NovaPrime18/GaNymede/GaNymede/Phase_gate.png

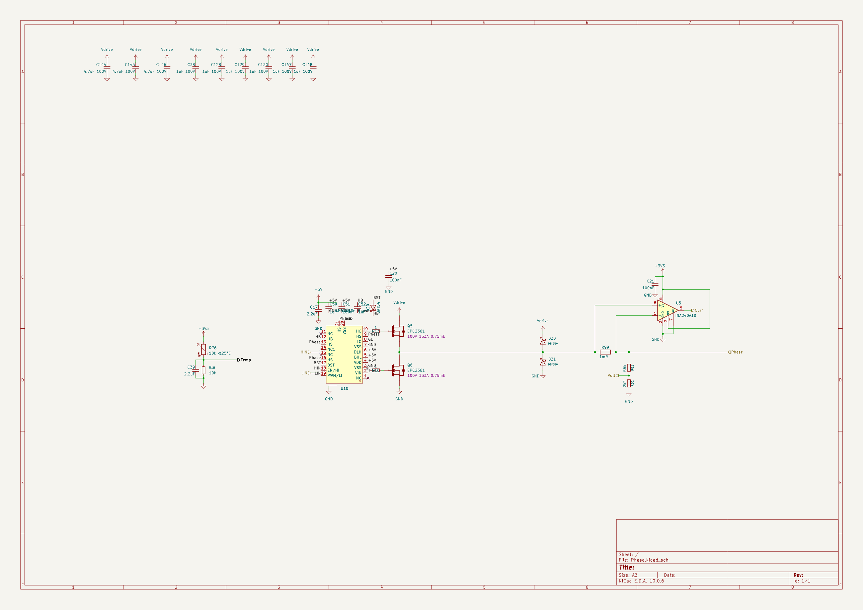
GaNymede/Phase_gate.png
