NovaPrime18/GaNymede/GaNymede/production/bom.csv

Designator | Footprint | Quantity | Value | LCSC Part #
C1, C15, C16, C18, C19, C20, C21, C29, C3, C30, C32, C36, C37, C4, C47, C5, C50, C52, C53, C58, C6, C60, C63, C7, C71, C77 | 0402 | 26 | 100nF | C307331
C10, C13, C14, C17, C27, C28, C39, C9 | 0402 | 8 | 2.2uF | C20539421
C11, C12 | 0402 | 2 | 15pF | C1548
C110, C111, C112, C113, C115, C116, C117, C118 | CP_Elec_10x10 | 8 | 100uF 80V | C487410
C119 | 0402 | 1 | 100n
C122, C123, C124, C125, C126, C127, C128, C129, C130, C136, C137, C138, C139, C147, C148, C33, C35, C38 | 0805 | 18 | 1uF 100V | C5370002
C134, C135, C140, C141, C142, C143, C144, C145, C146 | 1206 | 9 | 4.7uF 100V | C22367839
C150, C151, C152, C153, C154, C155, C156, C157, C158, C159, C160, C161 | CP_Elec_8x10 | 12 | 47uF 100V | C48935391
C2, C34, C8 | 0805 | 3 | 10uF | C440198
C201, C202, C203 | 0805 | 3 | 2.2nF 100V | C107136
C31 | 0402 | 1 | 1uF | C52923
C48, C57, C66 | 0402 | 3 | 15nF | C114405
C49, C59, C68 | 0402 | 3 | 1nF | C1523
C51, C64, C70, C74, C75, C76 | 0402 | 6 | 1uF
C54, C67, C73 | 0402 | 3 | 100nF
C55, C90 | 0603 | 2 | 100n X7R 100V | C15725
C56, C61, C62, C86, C87, C88 | 0805 | 6 | 1u X7R 100V | C5370002
C65, C69, C72, C91, C92, C93 | 0805 | 6 | 10u X7R 25V | C3039694
D1 | 0603 | 1 | Red | C2286
D14, D23 | D_SOD-123F | 2 | MBR1H100SFT3G | C235757
D2 | 0603 | 1 | Green | C84267
D22, D24, D25 | 0603 | 3 | LED | C2286
D27 | D_SMA | 1 | SMAJ60A | C42394398
D4 | D_SOD-123 | 1 | BAV16W | C459527
D6, D7, D8 | D_SOD-323 | 3 | BAT46WS | C7502692
F2 | 0805 | 1 | 0.5A | C2833485
FB2 | 0402 | 1 | 600R@100MHz | C76884
J1 | TH_XT90PB-M | 1 | XT90 | C3040688
J4 | JST_PH_B6B-PH-SM4-TB_1x06-1MP_P2.00mm_Vertical | 1 | Hall | C471518
J5 | JST_PH_B8B-PH-SM4-TB_1x08-1MP_P2.00mm_Vertical | 1 | COMM | C495548
J7 | TYPE-C-SMD_HX-TYPE-C-16PIN | 1 | Connector, USB-TYPE-C-16P | C2927039
L2, L3 | L_Sunlord_SWPA4030S | 2 | 22uH 1A 0.29Ohm | C167883
Q1, Q2, Q3, Q4, Q5, Q6 | D0606F_100V | 6 | EPC2361
R1, R42, R43 | 0402 | 3 | 22 | C25092
R10 | 0402 | 1 | 4.7 | C25121
R100, R101, R102, R97, R98, R99 | 2512 | 6 | 0.5mR
R105, R106 | 0402 | 2 | 5.1k | C25905
R11, R12, R14, R18, R48, R49, R50 | 0402 | 7 | 10k | C25744
R13, R15, R16, R17, R19, R20 | 0402 | 6 | 2.2
R2, R3, R67, R72, R78 | 0402 | 5 | 1k | C11702
R201, R202, R203 | 1210 | 3 | 1 | C2974068
R39, R46, R51, R58 | 0603 | 4 | 56k | C23206
R4, R5, R6 | 0402 | 3 | 2k2
R40, R47, R52, R59 | 0402 | 4 | 2k2 | C25879
R41 | 0603 | 1 | 220 | C22962
R7 | 0402 | 1 | 10k
R74, R75, R76 | 0402 | 3 | 10k @25°C | C77131
R77, R95 | 0402 | 2 | 1k | C106235
R79 | 0402 | 1 | 50k | C25897
R86 | 0402 | 1 | 33k 1% | C138003
R92 | 0402 | 1 | 10k 0.1% | C190095
R93 | 0402 | 1 | 57.6k 0.1% | C852849
R94 | 0402 | 1 | 10k | C2906861
SW1, SW2 | SW_Push_1P1T_NO_CK_KMR2 | 2 | KMR211NGLFS | C221676
TP1 | TestPoint_Pad_D1.5mm | 1 | Enable
TP2 | TestPoint_Pad_D1.5mm | 1 | TestPoint
TP3 | TestPoint_Pad_D1.5mm | 1 | Red
TP4 | TestPoint_Pad_D1.5mm | 1 | Green
U1 | LQFP-64_10x10mm_P0.5mm | 1 | STM32F405RGTx | C15742
U10, U11, U12, U13, U14, U17 | SOT-353_SC-70-5 | 6 | 74LVC1G66 | C97489
U15, U16 | SOT-23-6 | 2 | LMR16006XDDCR | C87080
U18, U7 | HVSON-8-1EP_3x3mm_P0.65mm_EP1.6x2.4mm | 2 | TJA1051TK-3 | C2875699
U19, U20, U21 | WQFN-19_L4.0-W3.0-P0.50-BL-EP_LMG1210RVRR | 3 | LMG1210 | C2677136
U3, U4, U5 | SOIC-8_3.9x4.9mm_P1.27mm | 3 | INA240A1D | C1346458
U8 | ESP32-C3-WROOM-02 | 1 | ESP32-C3-WROOM-02 | C2934560
Y1 | Crystal_SMD_3225-4Pin_3.2x2.5mm | 1 | 8M | C2682775
