NovaPrime18/GaNymede/GaNymede/GaNymede-Housing.FCStd

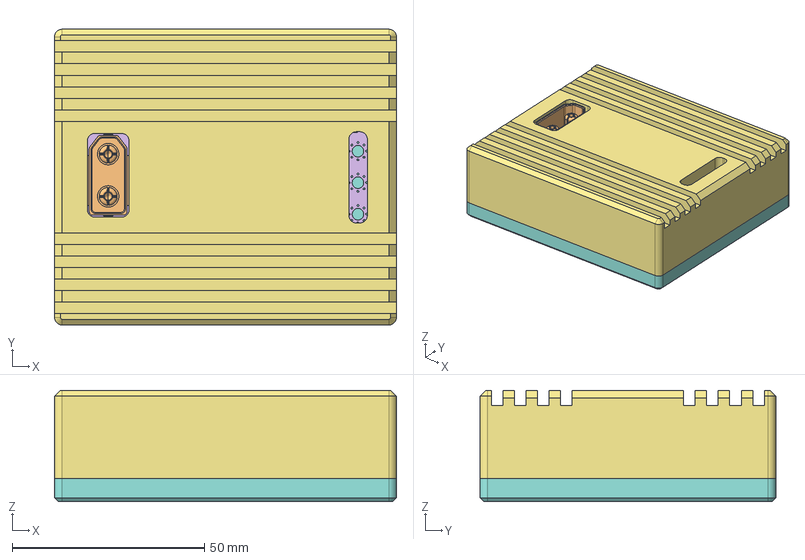
[picture p4: CAD file, 2026-11-08]
GaNymede/GaNymede-Housing.FCStd
89.0 x 77.0 x 29.0 mm
C_0805_2012Metric
R_0402_1005Metric
C_0805_2012Metric002
C_0805_2012Metric004
D_SOD_323
R_2512_6332Metric
C_0402_1005Metric
CP_Elec_10x10
C_0805_2012Metric006
R_2512_6332Metric002
R_0402_1005Metric002
C_0402_1005Metric002
R_1210_3225Metric
C_1206_3216Metric
R_0402_1005Metric004
Green001
Green002
Green003
Green004
Green005
Green006
Green007
Extruded
Extruded001
Extruded002
Extruded003
Extruded004
Extruded005
Extruded006
Extruded007
Extruded008
C_0805_2012Metric008
C_0805_2012Metric010
C_0402_1005Metric004
C_0402_1005Metric006
C_0805_2012Metric012
D_SOD_324
CP_Elec_10x002
R_1210_3225Metric002
C_0805_2012Metric014
CP_Elec_8x10
R_0402_1005Metric006
Green009
Green010
Green011
Green012
Green013
Green014
Green015
Extruded009
Extruded010
Extruded011
Extruded012
Extruded013
Extruded014
Extruded015
Extruded016
Extruded017
C_0402_1005Metric008
CP_Elec_8x002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
