NovaPrime18/GaNymede/GaNymede/GaNymede.step

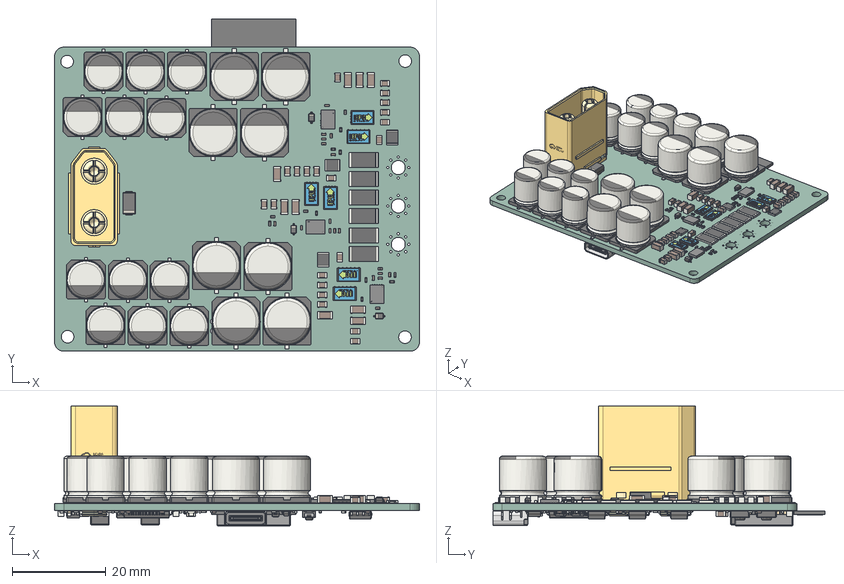
[picture p5: CAD file, 2026-11-08]
GaNymede/GaNymede.step
78.0 x 71.0 x 25.6 mm
C_0805_2012Metric x 36
R_0402_1005Metric x 42
D_SOD_323 x 3
R_2512_6332Metric x 6
C_0402_1005Metric x 53
CP_Elec_10x10 x 8
R_1210_3225Metric x 3
C_1206_3216Metric x 9
Green001 x 6
Green002 x 6
Green003 x 6
Green004 x 6
Green005 x 6
Green006 x 6
Green007 x 6
Extruded x 6
Extruded001 x 6
Extruded002 x 6
Extruded003 x 6
Extruded004 x 24
Extruded008 x 6
CP_Elec_8x10 x 12
WQFN-19_L4.0-W3.0-P0.50-BL-EP_LMG1210RVRR x 3
D_SMA
TH_XT90PB-M
SOT-353_SC-70-5 x 6
SOT-23-6 x 2
R_0603_1608Metric x 5
D_SOD_123F x 2
Crystal_SMD_3225-4Pin_3.2x2.5mm
LED_0603_1608Metric x 5
LQFP-64_10x10mm_P0.5mm
C_0603_1608Metric x 2
D_SOD-123
a68460a4-8551-11ed-a139-00155d22e2d7_part x 2
a684622a-8551-11ed-a139-00155d22e2d7_part x 2
a68462b6-8551-11ed-a139-00155d22e2d7_part x 2
R_0805_2012Metric
L_0402_1005Metric
SW_Push_1P1T_NO_CK_KMR2 x 2
SOIC-8_3.9x4.9mm_P1.27mm x 3
ESP32-C3-WROOM-02
TYPE-C-SMD_HX-TYPE-C-16PIN
GaNymede-unsaved-export-G2i9b3_PCB
