NovaPrime18/GaNymede/GaNymede/GaNymede-Housing-Housing-Bottom.step

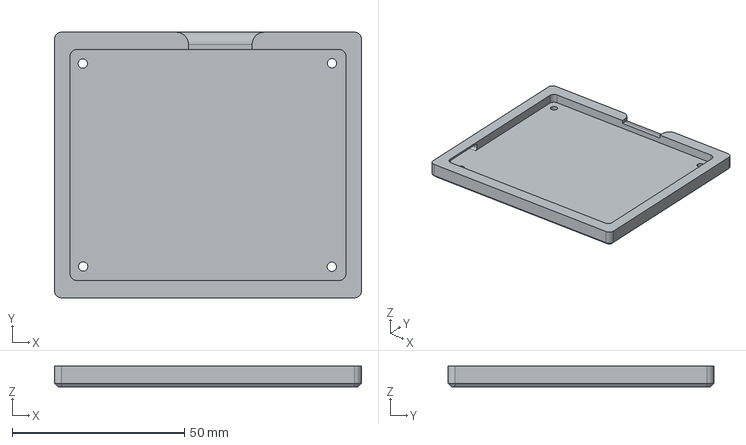
[picture p6: CAD file, 2026-11-08]
GaNymede/GaNymede-Housing-Housing-Bottom.step
89.0 x 77.0 x 6.00 mm
