NovaPrime18/GaNymede/GaNymede/GaNymede-Housing-Housing-Top.step

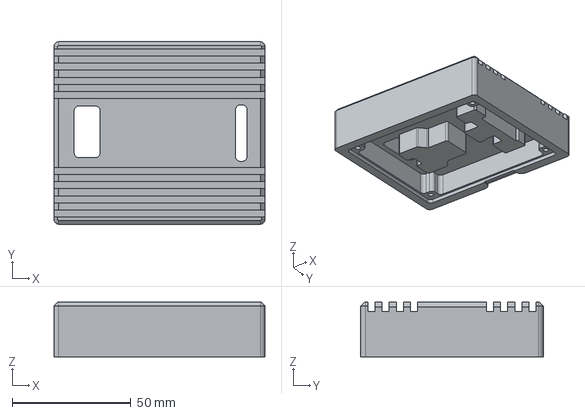
[picture p7: CAD file, 2026-11-08]
GaNymede/GaNymede-Housing-Housing-Top.step
89.0 x 77.0 x 23.0 mm
