NovaPrime18/GaNymede/GaNymede/GaNymede.kicad_pcb

## KiCad design GaNymede/GaNymede.kicad_pcb (2026-11-08)

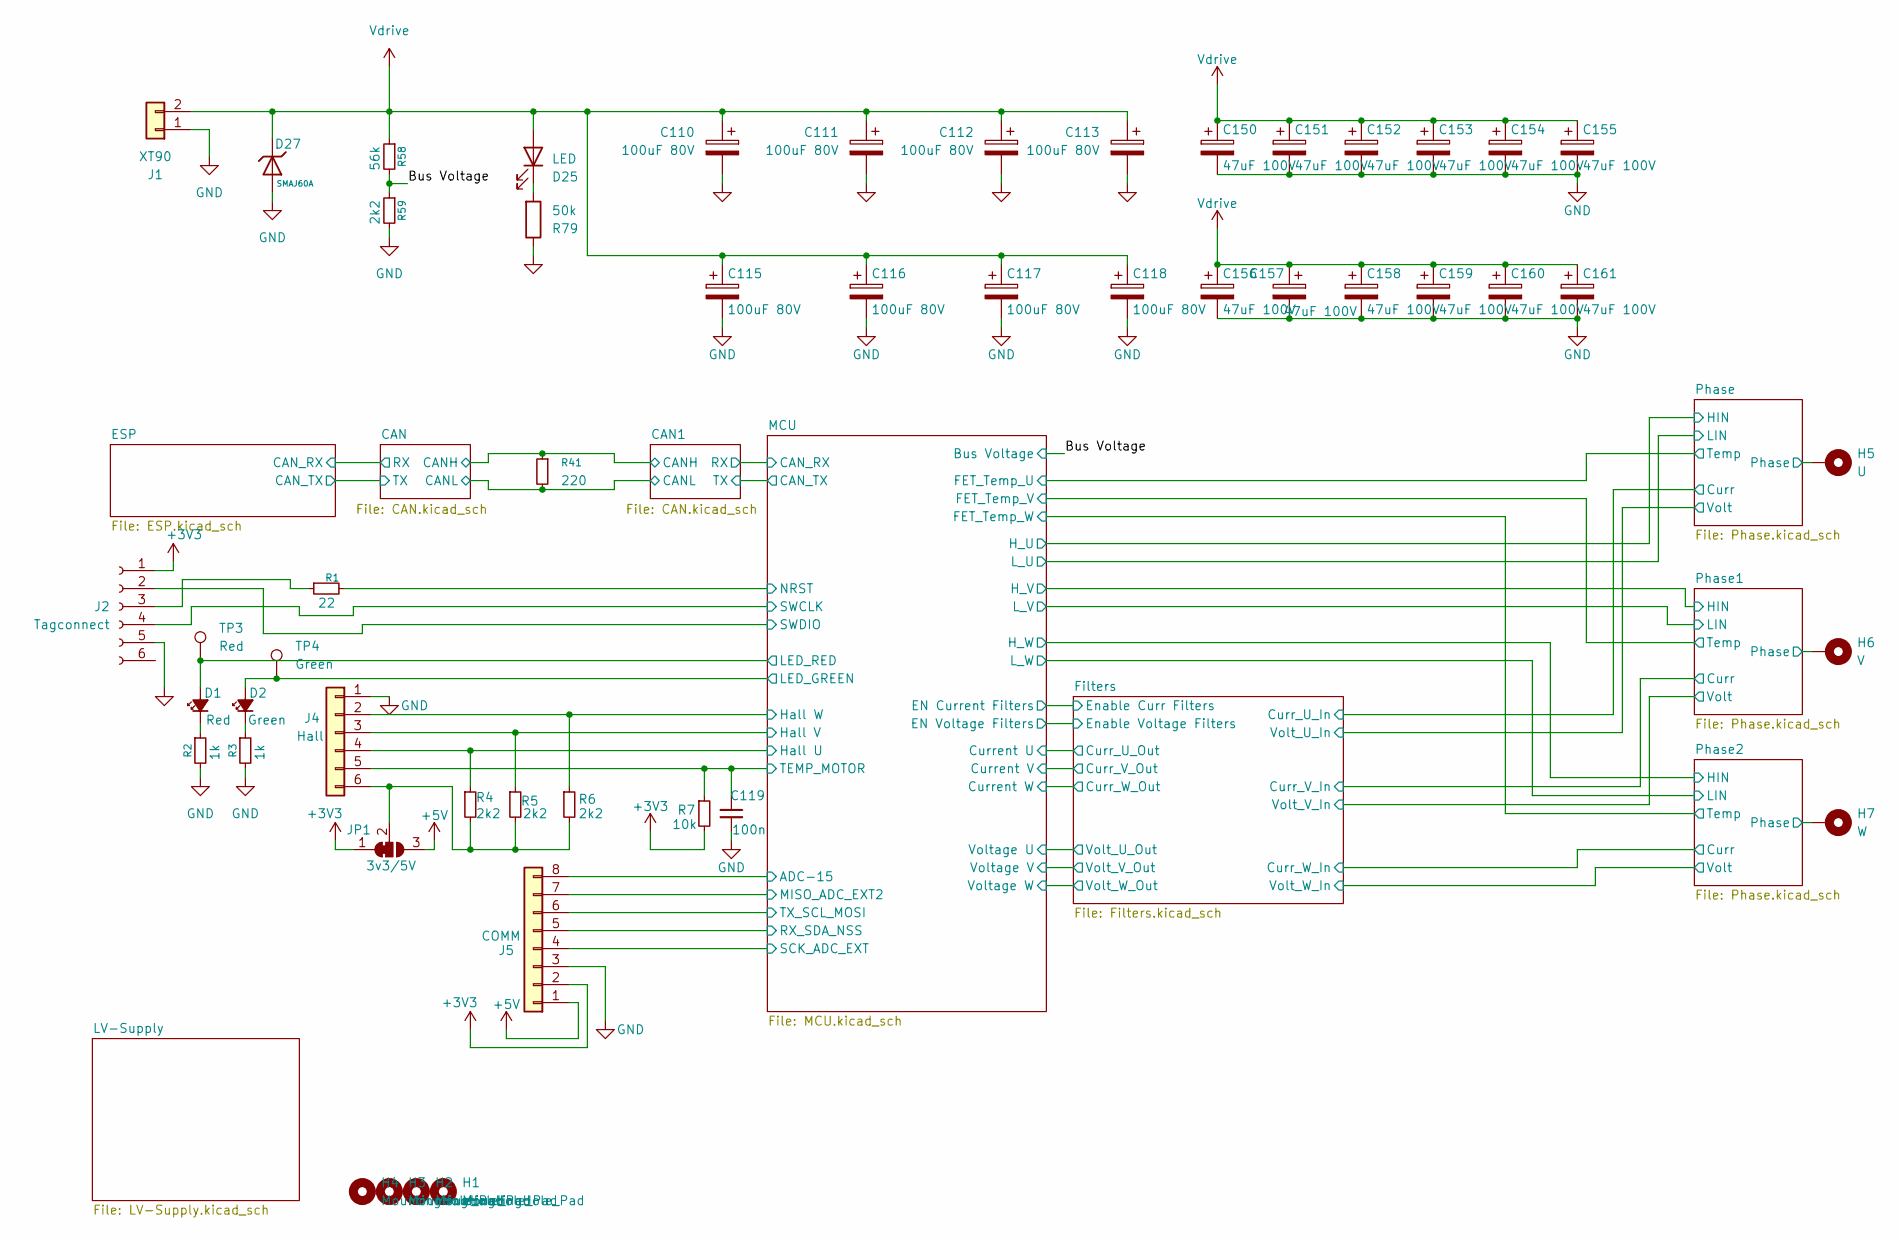
[picture p9: schematic GaNymede.kicad_sch]

Parts:
C110, C111, C112, C113, C115, C116, C117, C118: 100uF 80V; CP_Elec_10x10; LCSC C487410
C119: 100n; C_0402_1005Metric
C150, C151, C152, C153, C154, C155, C156, C157, C158, C159, C160, C161: 47uF 100V; CP_Elec_8x10; MPN RV100V47M8X10; LCSC C48935391
D1: Red; LED_0603_1608Metric; LCSC C2286
D2: Green; LED_0603_1608Metric; LCSC C84267
D25: LED; LED_0603_1608Metric; LCSC C2286
D27: SMAJ60A; D_SMA; Part SMAJ60A; LCSC C42394398
H1, H2, H3, H4: MountingHole_Pad; MountingHole_2.7mm_M2.5
H5: U; MountingHole_3mm_Pad_Via
H6: V; MountingHole_3mm_Pad_Via
H7: W; MountingHole_3mm_Pad_Via
J1: XT90; TH_XT90PB-M; JLC C3040688
J2: Tagconnect; Tag-Connect_TC2030-IDC-NL_2x03_P1.27mm_Vertical
J4: Hall; JST_PH_B6B-PH-SM4-TB_1x06-1MP_P2.00mm_Vertical; LCSC C471518
J5: COMM; JST_PH_B8B-PH-SM4-TB_1x08-1MP_P2.00mm_Vertical; LCSC C495548
JP1: 3v3/5V; SolderJumper-3_P1.3mm_Bridged12_RoundedPad1.0x1.5mm
R1: 22; R_0402_1005Metric; LCSC C25092
R2, R3: 1k; R_0402_1005Metric; LCSC C11702
R4, R5, R6: 2k2; R_0402_1005Metric
R7: 10k; R_0402_1005Metric
R41: 220; R_0603_1608Metric; LCSC C22962
R58: 56k; R_0603_1608Metric; LCSC C23206
R59: 2k2; R_0402_1005Metric; LCSC C25879
R79: 50k; R_0402_1005Metric; LCSC C25897
TP3: Red; TestPoint_Pad_D1.5mm
TP4: Green; TestPoint_Pad_D1.5mm

Connections:
+3V3: J2.1, J5.2, JP1.1 (A), R7.2; also elsewhere on the board
+5V: J5.1, JP1.3 (B); also elsewhere on the board
/Bus Voltage: R58.2, R59.1; also elsewhere on the board
/CAN/CANH: R41.1; also elsewhere on the board
/CAN/CANL: R41.2; also elsewhere on the board
/MCU/ADC-15: J5.8; also elsewhere on the board
/MCU/Hall U: J4.4, R4.1; also elsewhere on the board
/MCU/Hall V: J4.3, R5.1; also elsewhere on the board
/MCU/Hall W: J4.2, R6.1; also elsewhere on the board
/MCU/LED_GREEN: D2.2 (A), TP4.1 (1_1); also elsewhere on the board
/MCU/LED_RED: D1.2 (A), TP3.1 (1_1); also elsewhere on the board
/MCU/MISO_ADC_EXT2: J5.7; also elsewhere on the board
/MCU/NRST: R1.2; also elsewhere on the board
/MCU/RX_SDA_NSS: J5.5; also elsewhere on the board
/MCU/SCK_ADC_EXT: J5.4; also elsewhere on the board
/MCU/SWCLK: J2.4; also elsewhere on the board
/MCU/SWDIO: J2.2; also elsewhere on the board
/MCU/TEMP_MOTOR: C119.1, J4.5, R7.1; also elsewhere on the board
/MCU/TX_SCL_MOSI: J5.6; also elsewhere on the board
/Phase1/Phase: H6.1 (1_1); also elsewhere on the board
/Phase2/Phase: H7.1 (1_1); also elsewhere on the board
/Phase/Phase: H5.1 (1_1); also elsewhere on the board
GND: C110.2, C111.2, C112.2, C113.2, C115.2, C116.2, C117.2, C118.2, C119.2, C150.2, C151.2, C152.2, C153.2, C154.2, C155.2, C156.2, C157.2, C158.2, C159.2, C160.2, C161.2, D27.2, J1.1, J2.5, J4.1, J5.3, R2.2, R3.2, R59.2, R79.1; also elsewhere on the board
unnamed: D1.1 (K), R2.1
unnamed: D2.1 (K), R3.1
unnamed: D25.1 (K), R79.2
unnamed: J2.3, R1.1
unnamed: J4.6, JP1.2 (C), R4.2, R5.2, R6.2
Vdrive: C110.1, C111.1, C112.1, C113.1, C115.1, C116.1, C117.1, C118.1, C150.1, C151.1, C152.1, C153.1, C154.1, C155.1, C156.1, C157.1, C158.1, C159.1, C160.1, C161.1, D25.2 (A), D27.1, J1.2, R58.1; also elsewhere on the board

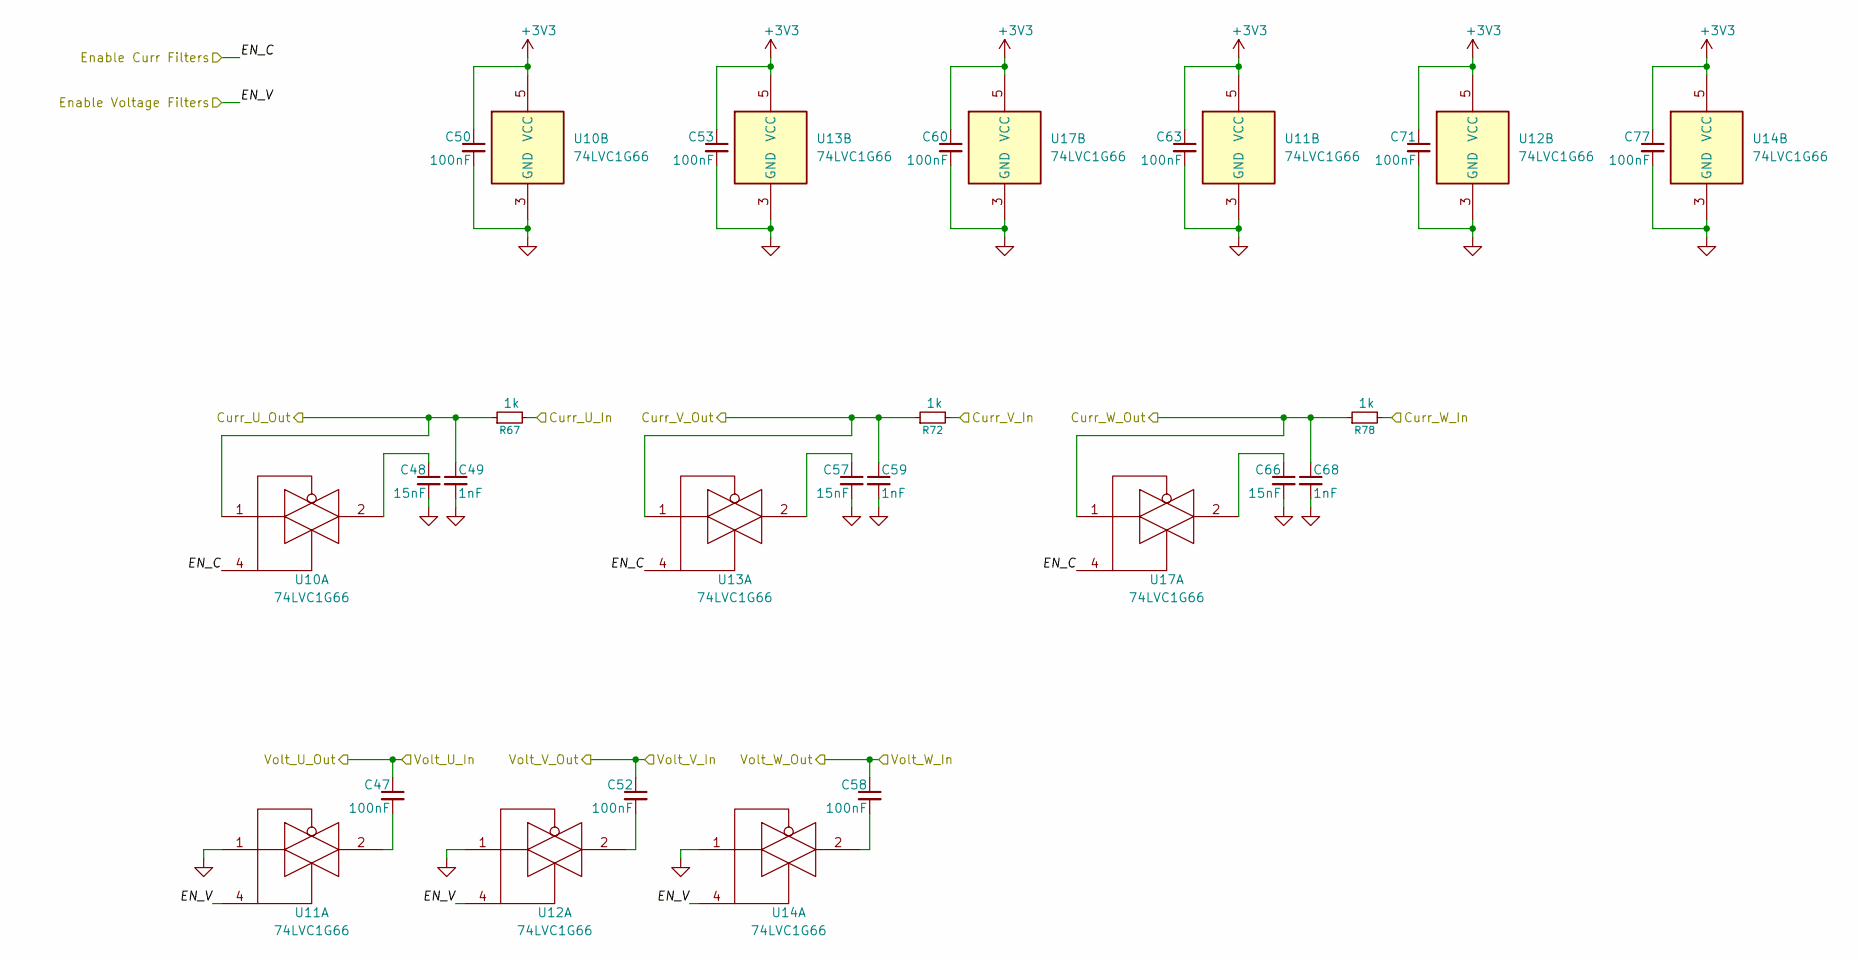
[picture p10: schematic Filters.kicad_sch]

Parts:
C47, C50, C52, C53, C58, C60, C63, C71, C77: 100nF; C_0402_1005Metric; LCSC C307331
C48, C57, C66: 15nF; C_0402_1005Metric; LCSC C114405
C49, C59, C68: 1nF; C_0402_1005Metric; LCSC C1523
R67, R72, R78: 1k; R_0402_1005Metric; LCSC C11702
U10, U11, U12, U13, U14, U17: 74LVC1G66; SOT-353_SC-70-5; JLC C97489

Connections:
+3V3: C50.1, C53.1, C60.1, C63.1, C71.1, C77.1, U10.5 (VCC), U11.5 (VCC), U12.5 (VCC), U13.5 (VCC), U14.5 (VCC), U17.5 (VCC); also elsewhere on the board
/Filters/Curr_U_In: R67.2; also elsewhere on the board
/Filters/Curr_U_Out: C49.1, R67.1, U10.1; also elsewhere on the board
/Filters/Curr_V_In: R72.2; also elsewhere on the board
/Filters/Curr_V_Out: C59.1, R72.1, U13.1; also elsewhere on the board
/Filters/Curr_W_In: R78.2; also elsewhere on the board
/Filters/Curr_W_Out: C68.1, R78.1, U17.1; also elsewhere on the board
/Filters/EN_C: U10.4, U13.4, U17.4; also elsewhere on the board
/Filters/EN_V: U11.4, U12.4, U14.4; also elsewhere on the board
/Filters/Volt_U_In: C47.1; also elsewhere on the board
/Filters/Volt_V_In: C52.1; also elsewhere on the board
/Filters/Volt_W_In: C58.1; also elsewhere on the board
GND: C48.2, C49.2, C50.2, C53.2, C57.2, C59.2, C60.2, C63.2, C66.2, C68.2, C71.2, C77.2, U10.3 (GND), U11.1, U11.3 (GND), U12.1, U12.3 (GND), U13.3 (GND), U14.1, U14.3 (GND), U17.3 (GND); also elsewhere on the board
unnamed: C47.2, U11.2
unnamed: C48.1, U10.2
unnamed: C52.2, U12.2
unnamed: C57.1, U13.2
unnamed: C58.2, U14.2
unnamed: C66.1, U17.2

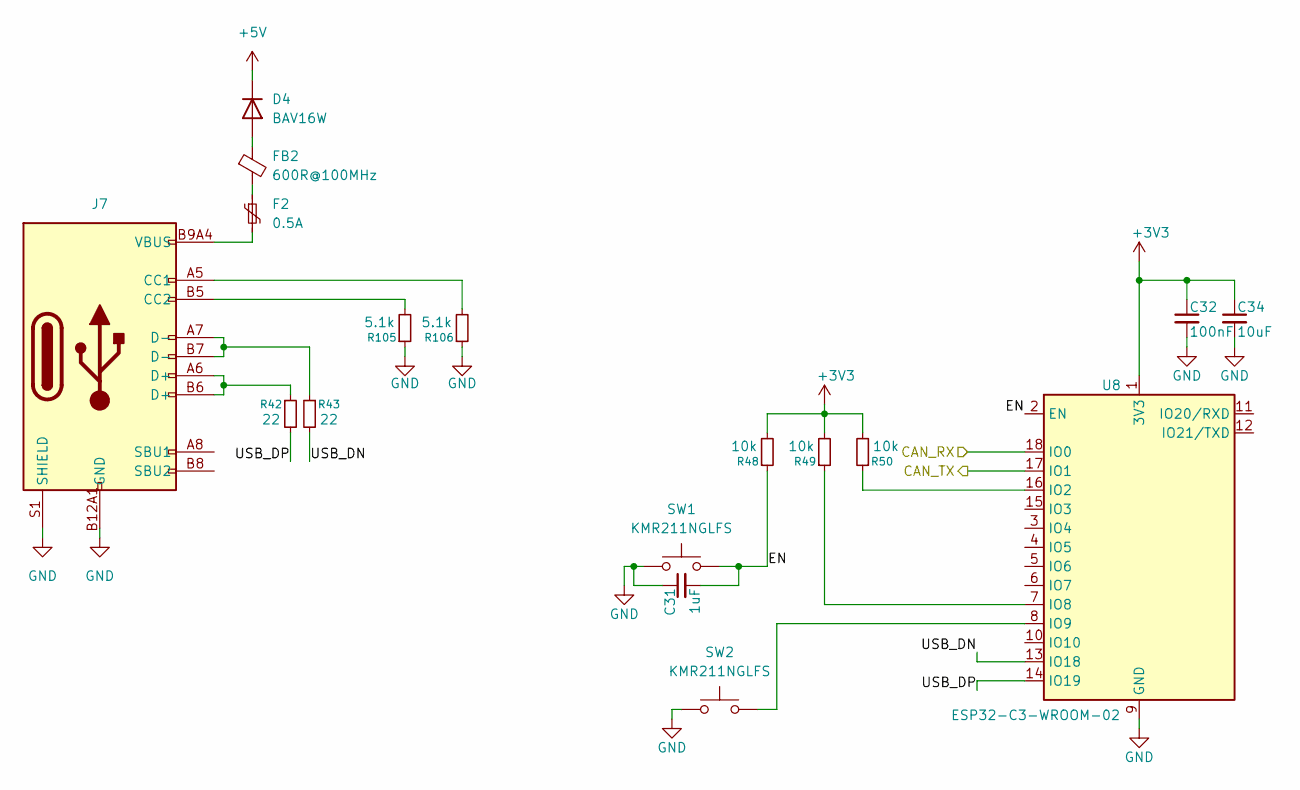
[picture p11: schematic ESP.kicad_sch]

Parts:
C31: 1uF; C_0402_1005Metric; LCSC C52923
C32: 100nF; C_0402_1005Metric; LCSC C307331
C34: 10uF; C_0805_2012Metric; LCSC C440198
D4: BAV16W; D_SOD-123; JLC C459527
F2: 0.5A; R_0805_2012Metric; JLC C2833485
FB2: 600R@100MHz; L_0402_1005Metric; LCSC C76884
J7: Connector, USB-TYPE-C-16P; TYPE-C-SMD_HX-TYPE-C-16PIN; LCSC C2927039
R42, R43: 22; R_0402_1005Metric; LCSC C25092
R48, R49, R50: 10k; R_0402_1005Metric; LCSC C25744
R105, R106: 5.1k; R_0402_1005Metric; LCSC C25905
SW1, SW2: KMR211NGLFS; SW_Push_1P1T_NO_CK_KMR2; JLC C221676
U8: ESP32-C3-WROOM-02; JLC C2934560

Connections:
+3V3: C32.1, C34.1, R48.2, R49.2, R50.2, U8.1 (3V3); also elsewhere on the board
+5V: D4.1 (K); also elsewhere on the board
/CAN/RX: U8.18 (IO0); also elsewhere on the board
/CAN/TX: U8.17 (IO1); also elsewhere on the board
/ESP/EN: C31.2, R48.1, SW1.2, U8.2 (EN)
/ESP/USB_DN: R43.2, U8.13 (IO18)
/ESP/USB_DP: R42.2, U8.14 (IO19)
GND: C31.1, C32.2, C34.2, J7.A12B1 (GND), J7.B12A1 (GND), J7.S1 (SHIELD), R105.1, R106.1, SW1.1, SW2.1, U8.9 (GND), U8.19 (GND); also elsewhere on the board
unnamed: D4.2 (A), FB2.1
unnamed: F2.1, FB2.2
unnamed: F2.2, J7.A9B4 (VBUS), J7.B9A4 (VBUS)
unnamed: J7.A5 (CC1), R106.2
unnamed: J7.B5 (CC2), R105.2
unnamed: J7.A6 (D+), J7.B6 (D+), R42.1
unnamed: J7.A7 (D-), J7.B7 (D-), R43.1
unnamed: R50.1, U8.16 (IO2)
unnamed: R49.1, U8.7 (IO8)
unnamed: SW2.2, U8.8 (IO9)

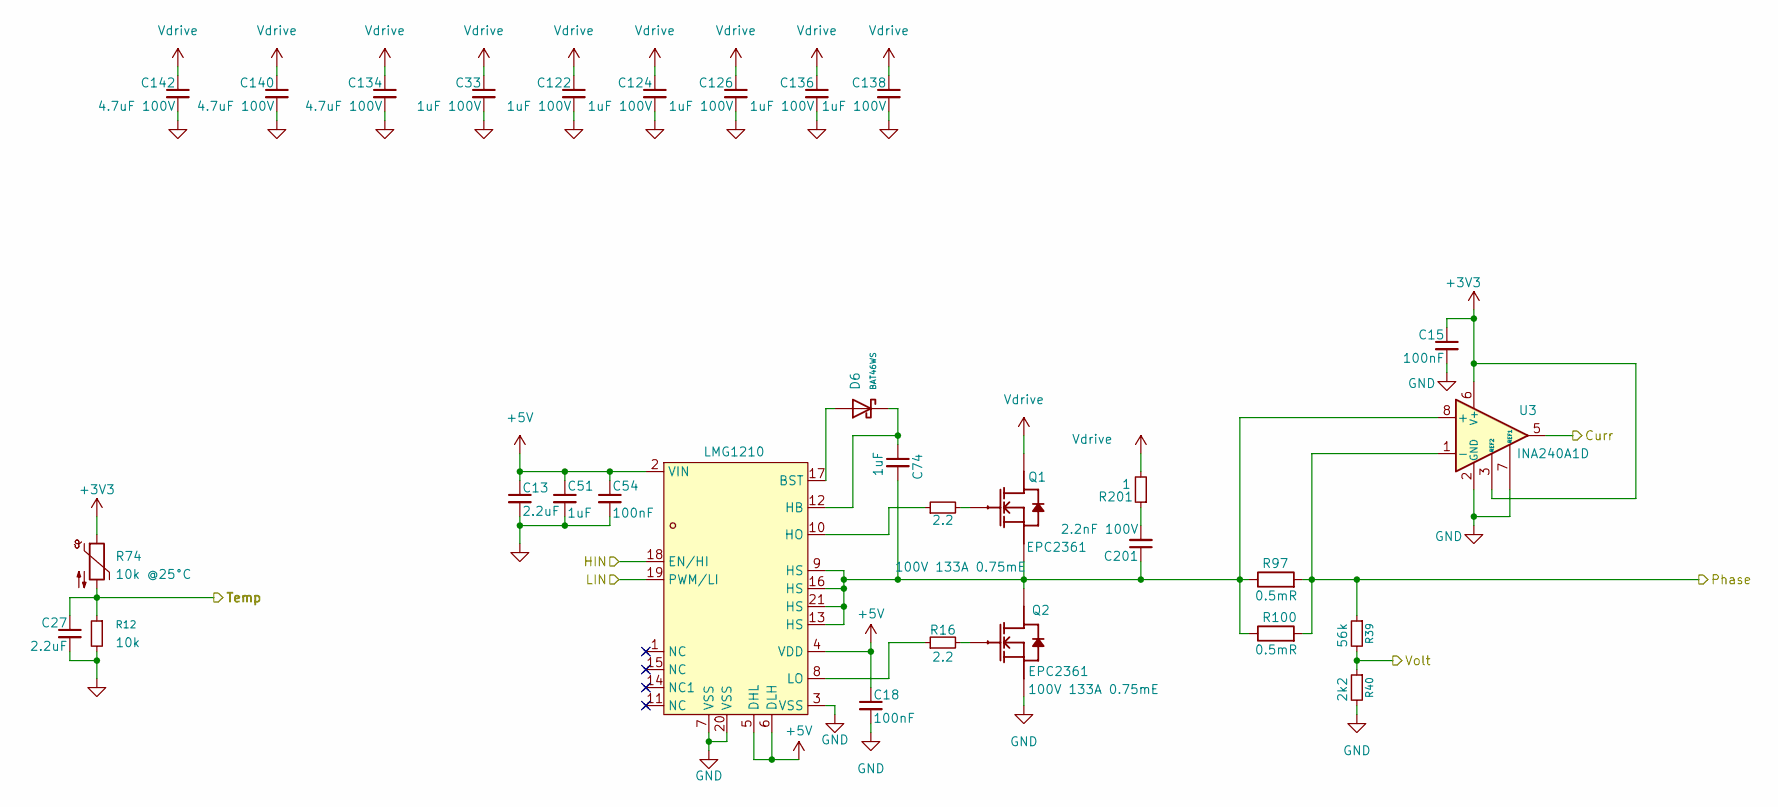
[picture p12: schematic Phase.kicad_sch]

Parts:
C13, C27: 2.2uF; C_0402_1005Metric; LCSC C20539421
C15, C18: 100nF; C_0402_1005Metric; LCSC C307331
C33, C122, C124, C126, C136, C138: 1uF 100V; C_0805_2012Metric; LCSC C5370002
C51, C74: 1uF; C_0402_1005Metric
C54: 100nF; C_0402_1005Metric
C134, C140, C142: 4.7uF 100V; C_1206_3216Metric; LCSC C22367839
C201: 2.2nF 100V; C_0805_2012Metric; MPN CC0805KRX7R0BB222; LCSC C107136
D6: BAT46WS; D_SOD-323; Forward Voltage (Vf@If) 1V@250mA; Reverse Voltage (Vr) 100V; Part BAT46WS; LCSC C7502692
Q1, Q2: EPC2361; D0606F_100V
R12: 10k; R_0402_1005Metric; LCSC C25744
R13, R16: 2.2; R_0402_1005Metric
R39: 56k; R_0603_1608Metric; LCSC C23206
R40: 2k2; R_0402_1005Metric; LCSC C25879
R74: 10k @25°C; R_0402_1005Metric; LCSC C77131
R97, R100: 0.5mR; R_2512_6332Metric
R201: 1; R_1210_3225Metric; MPN FRC1210J1R0 TS; LCSC C2974068
U3: INA240A1D; SOIC-8_3.9x4.9mm_P1.27mm; LCSC C1346458
U19: LMG1210; WQFN-19_L4.0-W3.0-P0.50-BL-EP_LMG1210RVRR; MPN LMG1210RVRR; LCSC Part C2677136

Connections:
+3V3: C15.1, R74.1, U3.3 (REF2), U3.6 (V+); also elsewhere on the board
+5V: C13.1, C18.1, C51.1, C54.1, U19.2 (VIN), U19.4 (VDD), U19.5 (DHL), U19.6 (DLH); also elsewhere on the board
/Filters/Curr_U_In: U3.5; also elsewhere on the board
/Filters/Volt_U_In: R39.2, R40.1; also elsewhere on the board
/MCU/FET_Temp_U: C27.1, R12.1, R74.2; also elsewhere on the board
/MCU/H_U: U19.18 (EN/HI); also elsewhere on the board
/MCU/L_U: U19.19 (PWM/LI); also elsewhere on the board
/Phase/Phase: R39.1, R97.2, R100.2, U3.1 (-); also elsewhere on the board
GND: C13.2, C15.2, C18.2, C27.2, C33.2, C51.2, C54.2, C122.2, C124.2, C126.2, C134.2, C136.2, C138.2, C140.2, C142.2, Q2.2 (S), Q2.4 (S), Q2.6 (S), R12.2, R40.2, U3.2 (GND), U3.4 (GND), U3.7 (REF1), U19.3 (VSS), U19.7 (VSS), U19.20 (VSS); also elsewhere on the board
unnamed: C201.2, R201.1
unnamed: Q1.1 (G), R13.2
unnamed: Q2.1 (G), R16.2
unnamed: C74.2, C201.1, Q1.2 (S), Q1.4 (S), Q1.6 (S), Q2.3 (D), Q2.5 (D), Q2.7 (D), R97.1, R100.1, U3.8 (+), U19.9 (HS), U19.13 (HS), U19.16 (HS), U19.21 (HS)
unnamed: D6.2, U19.17 (BST)
unnamed: C74.1, D6.1, U19.12 (HB)
unnamed: R13.1, U19.10 (HO)
unnamed: R16.1, U19.8 (LO)
Vdrive: C33.1, C122.1, C124.1, C126.1, C134.1, C136.1, C138.1, C140.1, C142.1, Q1.3 (D), Q1.5 (D), Q1.7 (D), R201.2; also elsewhere on the board

Parts of its further copies:
C14, C17, C28, C39: 2.2uF; C_0402_1005Metric; LCSC C20539421
C16, C19, C20, C21: 100nF; C_0402_1005Metric; LCSC C307331
C35, C38, C123, C125, C127, C128, C129, C130, C137, C139, C147, C148: 1uF 100V; C_0805_2012Metric; LCSC C5370002
C64, C70, C75, C76: 1uF; C_0402_1005Metric
C67, C73: 100nF; C_0402_1005Metric
C135, C141, C143, C144, C145, C146: 4.7uF 100V; C_1206_3216Metric; LCSC C22367839
C202, C203: 2.2nF 100V; C_0805_2012Metric; MPN CC0805KRX7R0BB222; LCSC C107136
D7, D8: BAT46WS; D_SOD-323; Forward Voltage (Vf@If) 1V@250mA; Reverse Voltage (Vr) 100V; Part BAT46WS; LCSC C7502692
Q3, Q4, Q5, Q6: EPC2361; D0606F_100V
R14, R18: 10k; R_0402_1005Metric; LCSC C25744
R15, R17, R19, R20: 2.2; R_0402_1005Metric
R46, R51: 56k; R_0603_1608Metric; LCSC C23206
R47, R52: 2k2; R_0402_1005Metric; LCSC C25879
R75, R76: 10k @25°C; R_0402_1005Metric; LCSC C77131
R98, R99, R101, R102: 0.5mR; R_2512_6332Metric
R202, R203: 1; R_1210_3225Metric; MPN FRC1210J1R0 TS; LCSC C2974068
U4, U5: INA240A1D; SOIC-8_3.9x4.9mm_P1.27mm; LCSC C1346458
U20, U21: LMG1210; WQFN-19_L4.0-W3.0-P0.50-BL-EP_LMG1210RVRR; MPN LMG1210RVRR; LCSC Part C2677136

Connections of its further copies:
+3V3: C16.1, C21.1, R75.1, R76.1, U4.3 (REF2), U4.6 (V+), U5.3 (REF2), U5.6 (V+); also elsewhere on the board
+5V: C14.1, C17.1, C19.1, C20.1, C64.1, C67.1, C70.1, C73.1, U20.2 (VIN), U20.4 (VDD), U20.5 (DHL), U20.6 (DLH), U21.2 (VIN), U21.4 (VDD), U21.5 (DHL), U21.6 (DLH); also elsewhere on the board
/Filters/Curr_V_In: U4.5; also elsewhere on the board
/Filters/Curr_W_In: U5.5; also elsewhere on the board
/Filters/Volt_V_In: R46.2, R47.1; also elsewhere on the board
/Filters/Volt_W_In: R51.2, R52.1; also elsewhere on the board
/MCU/FET_Temp_V: C28.1, R14.1, R75.2; also elsewhere on the board
/MCU/FET_Temp_W: C39.1, R18.1, R76.2; also elsewhere on the board
/MCU/H_V: U20.18 (EN/HI); also elsewhere on the board
/MCU/H_W: U21.18 (EN/HI); also elsewhere on the board
/MCU/L_V: U20.19 (PWM/LI); also elsewhere on the board
/MCU/L_W: U21.19 (PWM/LI); also elsewhere on the board
/Phase1/Phase: R46.1, R98.2, R101.2, U4.1 (-); also elsewhere on the board
/Phase2/Phase: R51.1, R99.2, R102.2, U5.1 (-); also elsewhere on the board
GND: C14.2, C16.2, C17.2, C19.2, C20.2, C21.2, C28.2, C35.2, C38.2, C39.2, C64.2, C67.2, C70.2, C73.2, C123.2, C125.2, C127.2, C128.2, C129.2, C130.2, C135.2, C137.2, C139.2, C141.2, C143.2, C144.2, C145.2, C146.2, C147.2, C148.2, Q4.2 (S), Q4.4 (S), Q4.6 (S), Q6.2 (S), Q6.4 (S), Q6.6 (S), R14.2, R18.2, R47.2, R52.2, U4.2 (GND), U4.4 (GND), U4.7 (REF1), U5.2 (GND), U5.4 (GND), U5.7 (REF1), U20.3 (VSS), U20.7 (VSS), U20.20 (VSS), U21.3 (VSS), U21.7 (VSS), U21.20 (VSS); also elsewhere on the board
unnamed: C202.2, R202.1
unnamed: C203.2, R203.1
unnamed: Q3.1 (G), R15.2
unnamed: Q4.1 (G), R17.2
unnamed: Q5.1 (G), R20.2
unnamed: Q6.1 (G), R19.2
unnamed: C75.2, C202.1, Q3.2 (S), Q3.4 (S), Q3.6 (S), Q4.3 (D), Q4.5 (D), Q4.7 (D), R98.1, R101.1, U4.8 (+), U20.9 (HS), U20.13 (HS), U20.16 (HS), U20.21 (HS)
unnamed: C76.2, C203.1, Q5.2 (S), Q5.4 (S), Q5.6 (S), Q6.3 (D), Q6.5 (D), Q6.7 (D), R99.1, R102.1, U5.8 (+), U21.9 (HS), U21.13 (HS), U21.16 (HS), U21.21 (HS)
unnamed: D7.2, U20.17 (BST)
unnamed: C75.1, D7.1, U20.12 (HB)
unnamed: R15.1, U20.10 (HO)
unnamed: R17.1, U20.8 (LO)
unnamed: D8.2, U21.17 (BST)
unnamed: C76.1, D8.1, U21.12 (HB)
unnamed: R20.1, U21.10 (HO)
unnamed: R19.1, U21.8 (LO)
Vdrive: C35.1, C38.1, C123.1, C125.1, C127.1, C128.1, C129.1, C130.1, C135.1, C137.1, C139.1, C141.1, C143.1, C144.1, C145.1, C146.1, C147.1, C148.1, Q3.3 (D), Q3.5 (D), Q3.7 (D), Q5.3 (D), Q5.5 (D), Q5.7 (D), R202.2, R203.2; also elsewhere on the board

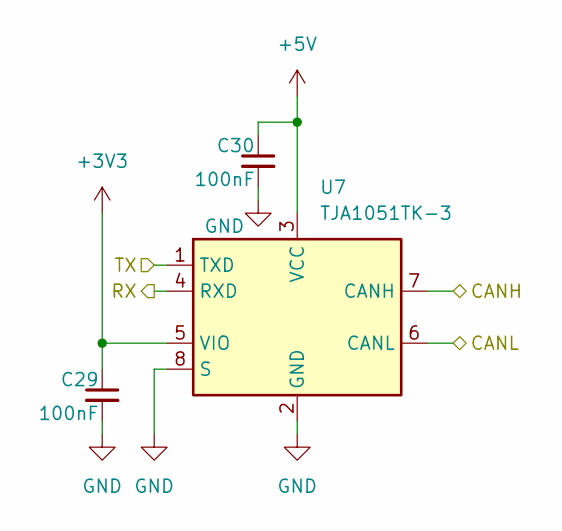
[picture p13: schematic CAN.kicad_sch]

Parts:
C29, C30: 100nF; C_0402_1005Metric; LCSC C307331
U7: TJA1051TK-3; HVSON-8-1EP_3x3mm_P0.65mm_EP1.6x2.4mm; JLC C2875699

Connections:
+3V3: C29.1, U7.5 (VIO); also elsewhere on the board
+5V: C30.1, U7.3 (VCC); also elsewhere on the board
/CAN/CANH: U7.7 (CANH); also elsewhere on the board
/CAN/CANL: U7.6 (CANL); also elsewhere on the board
/CAN/RX: U7.4 (RXD); also elsewhere on the board
/CAN/TX: U7.1 (TXD); also elsewhere on the board
GND: C29.2, C30.2, U7.2 (GND), U7.8 (S), U7.9 (GND); also elsewhere on the board

Parts of its further copies:
C36, C37: 100nF; C_0402_1005Metric; LCSC C307331
U18: TJA1051TK-3; HVSON-8-1EP_3x3mm_P0.65mm_EP1.6x2.4mm; JLC C2875699

Connections of its further copies:
+3V3: C36.1, U18.5 (VIO); also elsewhere on the board
+5V: C37.1, U18.3 (VCC); also elsewhere on the board
/CAN1/RX: U18.4 (RXD); also elsewhere on the board
/CAN1/TX: U18.1 (TXD); also elsewhere on the board
/CAN/CANH: U18.7 (CANH); also elsewhere on the board
/CAN/CANL: U18.6 (CANL); also elsewhere on the board
GND: C36.2, C37.2, U18.2 (GND), U18.8 (S), U18.9 (GND); also elsewhere on the board

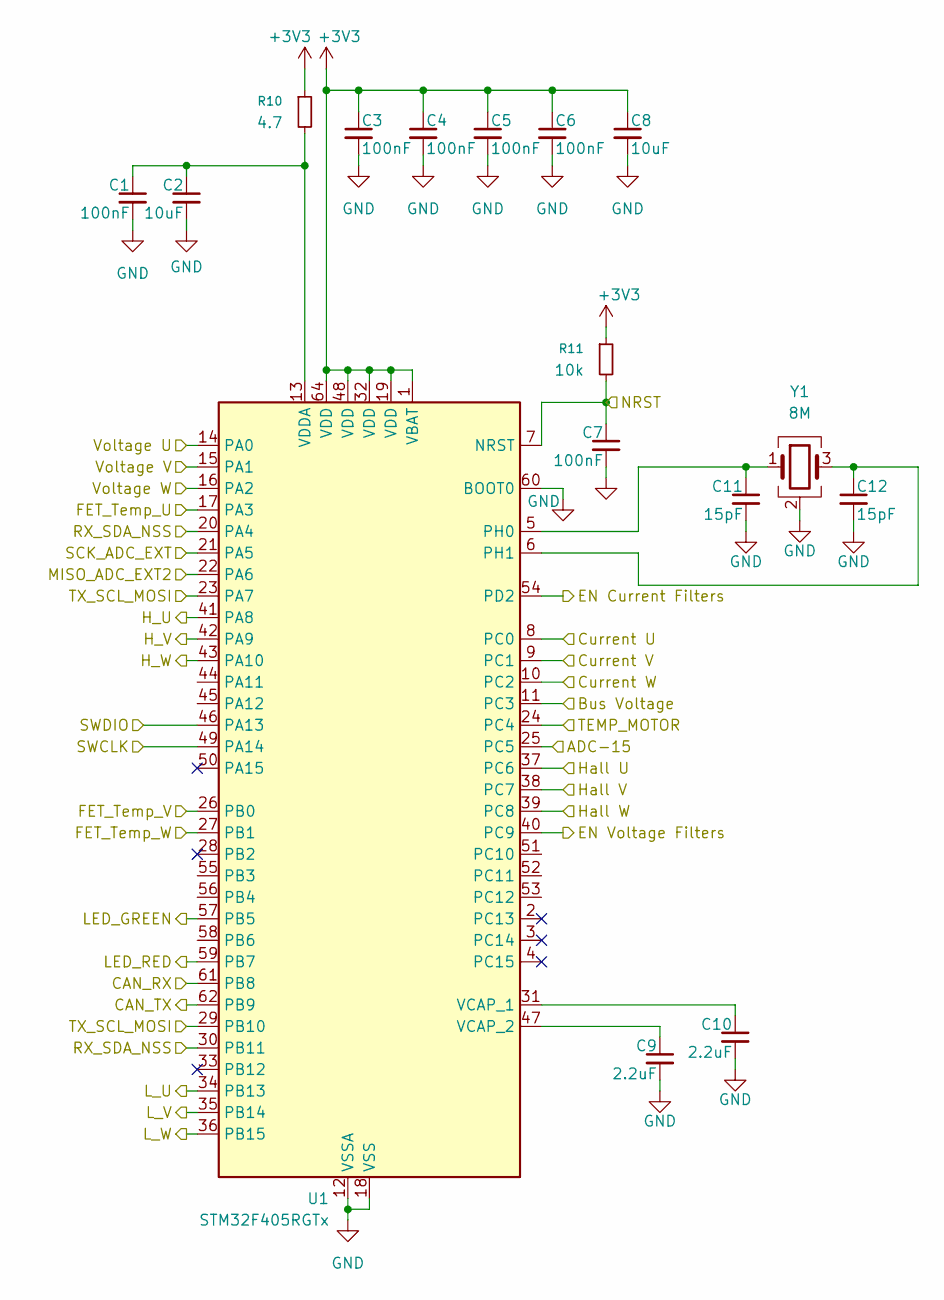
[picture p14: schematic MCU.kicad_sch]

Parts:
C1, C3, C4, C5, C6, C7: 100nF; C_0402_1005Metric; LCSC C307331
C2, C8: 10uF; C_0805_2012Metric; LCSC C440198
C9, C10: 2.2uF; C_0402_1005Metric; LCSC C20539421
C11, C12: 15pF; C_0402_1005Metric; LCSC C1548
R10: 4.7; R_0402_1005Metric; LCSC C25121
R11: 10k; R_0402_1005Metric; LCSC C25744
U1: STM32F405RGTx; LQFP-64_10x10mm_P0.5mm; LCSC C15742
Y1: 8M; Crystal_SMD_3225-4Pin_3.2x2.5mm; JLC C2682775

Connections:
+3V3: C3.1, C4.1, C5.1, C6.1, C8.1, R10.1, R11.1, U1.1 (VBAT), U1.19 (VDD), U1.32 (VDD), U1.48 (VDD), U1.64 (VDD); also elsewhere on the board
/Bus Voltage: U1.11 (PC3); also elsewhere on the board
/CAN1/RX: U1.61 (PB8); also elsewhere on the board
/CAN1/TX: U1.62 (PB9); also elsewhere on the board
/Filters/Curr_U_Out: U1.8 (PC0); also elsewhere on the board
/Filters/Curr_V_Out: U1.9 (PC1); also elsewhere on the board
/Filters/Curr_W_Out: U1.10 (PC2); also elsewhere on the board
/Filters/EN_C: U1.54 (PD2); also elsewhere on the board
/Filters/EN_V: U1.40 (PC9); also elsewhere on the board
/Filters/Volt_U_In: U1.14 (PA0); also elsewhere on the board
/Filters/Volt_V_In: U1.15 (PA1); also elsewhere on the board
/Filters/Volt_W_In: U1.16 (PA2); also elsewhere on the board
/MCU/ADC-15: U1.25 (PC5); also elsewhere on the board
/MCU/FET_Temp_U: U1.17 (PA3); also elsewhere on the board
/MCU/FET_Temp_V: U1.26 (PB0); also elsewhere on the board
/MCU/FET_Temp_W: U1.27 (PB1); also elsewhere on the board
/MCU/H_U: U1.41 (PA8); also elsewhere on the board
/MCU/H_V: U1.42 (PA9); also elsewhere on the board
/MCU/H_W: U1.43 (PA10); also elsewhere on the board
/MCU/Hall U: U1.37 (PC6); also elsewhere on the board
/MCU/Hall V: U1.38 (PC7); also elsewhere on the board
/MCU/Hall W: U1.39 (PC8); also elsewhere on the board
/MCU/LED_GREEN: U1.57 (PB5); also elsewhere on the board
/MCU/LED_RED: U1.59 (PB7); also elsewhere on the board
/MCU/L_U: U1.34 (PB13); also elsewhere on the board
/MCU/L_V: U1.35 (PB14); also elsewhere on the board
/MCU/L_W: U1.36 (PB15); also elsewhere on the board
/MCU/MISO_ADC_EXT2: U1.22 (PA6); also elsewhere on the board
/MCU/NRST: C7.1, R11.2, U1.7 (NRST); also elsewhere on the board
/MCU/RX_SDA_NSS: U1.20 (PA4), U1.30 (PB11); also elsewhere on the board
/MCU/SCK_ADC_EXT: U1.21 (PA5); also elsewhere on the board
/MCU/SWCLK: U1.49 (PA14); also elsewhere on the board
/MCU/SWDIO: U1.46 (PA13); also elsewhere on the board
/MCU/TEMP_MOTOR: U1.24 (PC4); also elsewhere on the board
/MCU/TX_SCL_MOSI: U1.23 (PA7), U1.29 (PB10); also elsewhere on the board
GND: C1.2, C2.2, C3.2, C4.2, C5.2, C6.2, C7.2, C8.2, C9.2, C10.2, C11.2, C12.2, U1.12 (VSSA), U1.18 (VSS), U1.60 (BOOT0), U1.63 (VSS), Y1.2 (G), Y1.4 (G); also elsewhere on the board
unnamed: C11.1, U1.5 (PH0), Y1.1
unnamed: C12.1, U1.6 (PH1), Y1.3
unnamed: C10.1, U1.31 (VCAP_1)
unnamed: C9.1, U1.47 (VCAP_2)
unnamed: C1.1, C2.1, R10.2, U1.13 (VDDA)

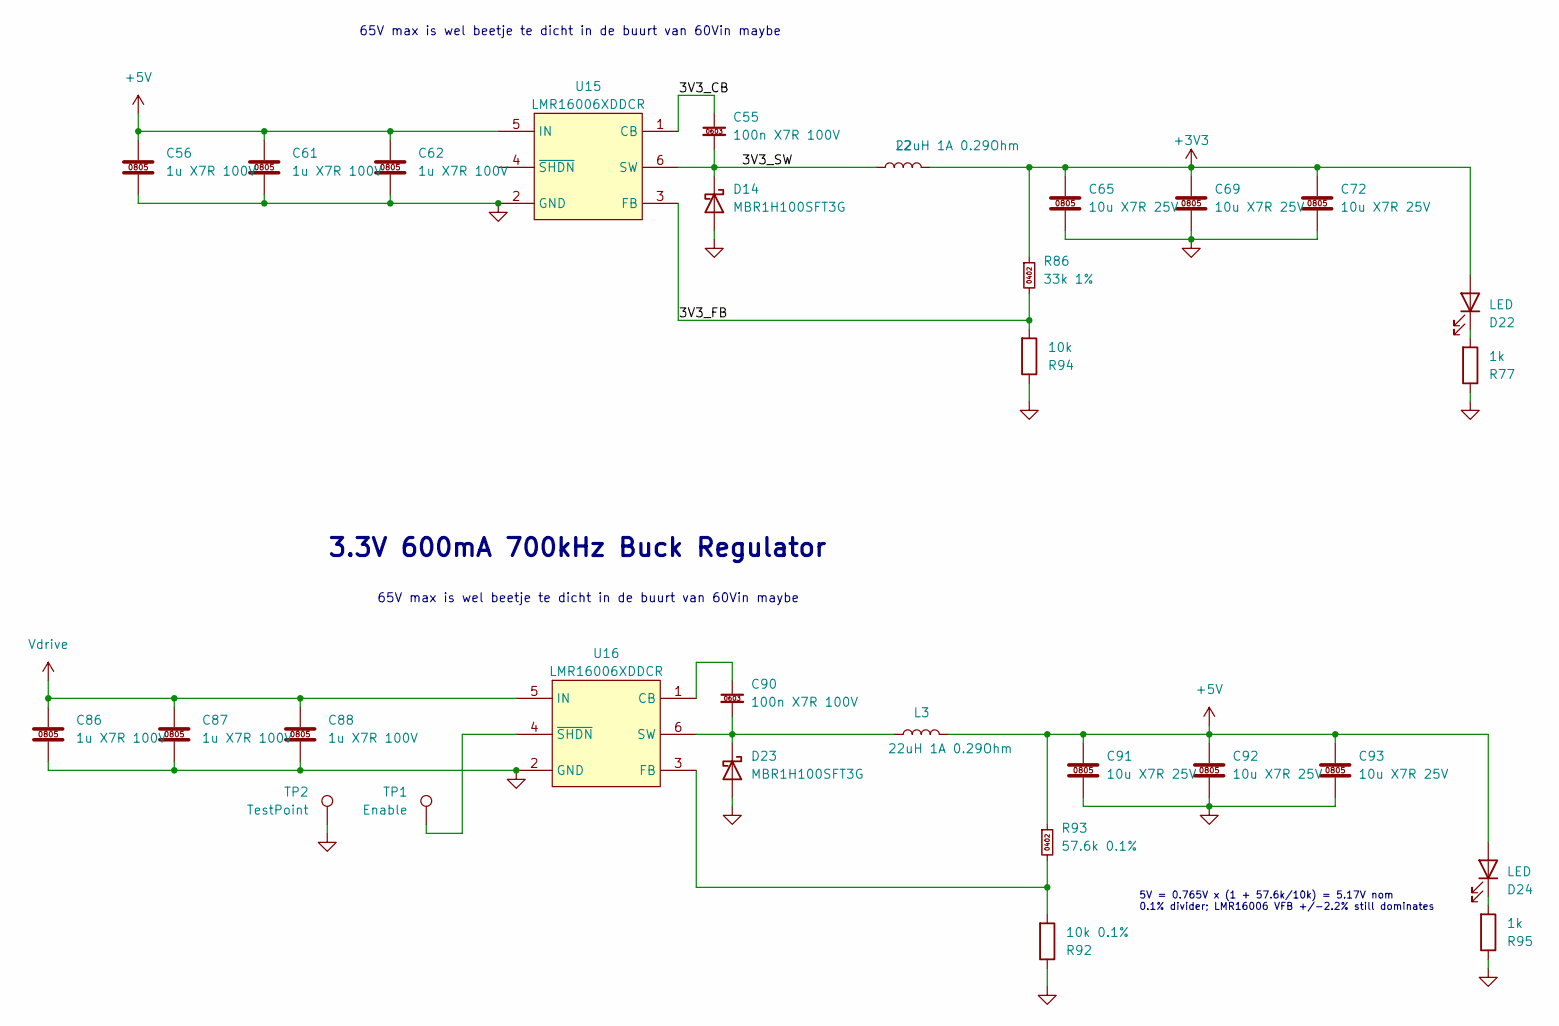
[picture p15: schematic LV-Supply.kicad_sch]

Parts:
C55, C90: 100n X7R 100V; C_0603_1608Metric; Manufacturer Part Number CL10B104KC8NNNC; LCSC C15725
C56, C61, C62, C86, C87, C88: 1u X7R 100V; C_0805_2012Metric; Manufacturer Part Number CC0805KKX7R0BB105; LCSC C5370002
C65, C69, C72, C91, C92, C93: 10u X7R 25V; C_0805_2012Metric; Manufacturer Part Number CL21B106KAYQNNE; LCSC C3039694
D14, D23: MBR1H100SFT3G; D_SOD-123F; Manufacturer Part Number MBR1H100SFT3G; LCSC C235757
D22, D24: LED; LED_0603_1608Metric; LCSC C2286
L2, L3: 22uH 1A 0.29Ohm; L_Sunlord_SWPA4030S; Manufacturer Part Number SWPA4030S220MT; LCSC C167883
R77, R95: 1k; R_0402_1005Metric; LCSC C106235
R86: 33k 1%; R_0402_1005Metric; Manufacturer Part Number RC0402FR-0733KL; LCSC C138003
R92: 10k 0.1%; R_0402_1005Metric; Tolerance ±0.1%; Manufacturer Part Number RT0402BRD0710KL; LCSC C190095
R93: 57.6k 0.1%; R_0402_1005Metric; Tolerance ±0.1%; Manufacturer Part Number RT0402BRD0757K6L; LCSC C852849
R94: 10k; R_0402_1005Metric; LCSC C2906861
TP1: Enable; TestPoint_Pad_D1.5mm
TP2: TestPoint; TestPoint_Pad_D1.5mm
U15, U16: LMR16006XDDCR; SOT-23-6; Manufacturer Part Number LMR16006XDDCR; LCSC C87080

Connections:
+3V3: C65.1, C69.1, C72.1, D22.2 (A), L2.2, R86.1; also elsewhere on the board
+5V: C56.1, C61.1, C62.1, C91.1, C92.1, C93.1, D24.2 (A), L3.2, R93.1, U15.5 (IN); also elsewhere on the board
/LV-Supply/3V3_CB: C55.1, U15.1 (CB)
/LV-Supply/3V3_FB: R86.2, R94.2, U15.3 (FB)
/LV-Supply/3V3_SW: C55.2, D14.1 (K), L2.1, U15.6 (SW)
GND: C56.2, C61.2, C62.2, C65.2, C69.2, C72.2, C86.2, C87.2, C88.2, C91.2, C92.2, C93.2, D14.2 (A), D23.2 (A), R77.1, R92.1, R94.1, R95.1, TP2.1 (1_1), U15.2 (GND), U16.2 (GND); also elsewhere on the board
unnamed: D22.1 (K), R77.2
unnamed: C90.2, D23.1 (K), L3.1, U16.6 (SW)
unnamed: D24.1 (K), R95.2
unnamed: C90.1, U16.1 (CB)
unnamed: R92.2, R93.2, U16.3 (FB)
unnamed: TP1.1 (1_1), U16.4 (~SHDN)
Vdrive: C86.1, C87.1, C88.1, U16.5 (IN); also elsewhere on the board

Notes on the sheet:
5V = 0.765V x (1 + 57.6k/10k) = 5.17V nom 0.1% divider; LMR16006 VFB +/-2.2% still dominates
65V max is wel beetje te dicht in de buurt van 60Vin maybe
3.3V 600mA 700kHz Buck Regulator
