NovaPrime18/GaNymede/GaNymede/GaNymede.kicad_pcb

## KiCad design GaNymede/GaNymede.kicad_pcb (continued)

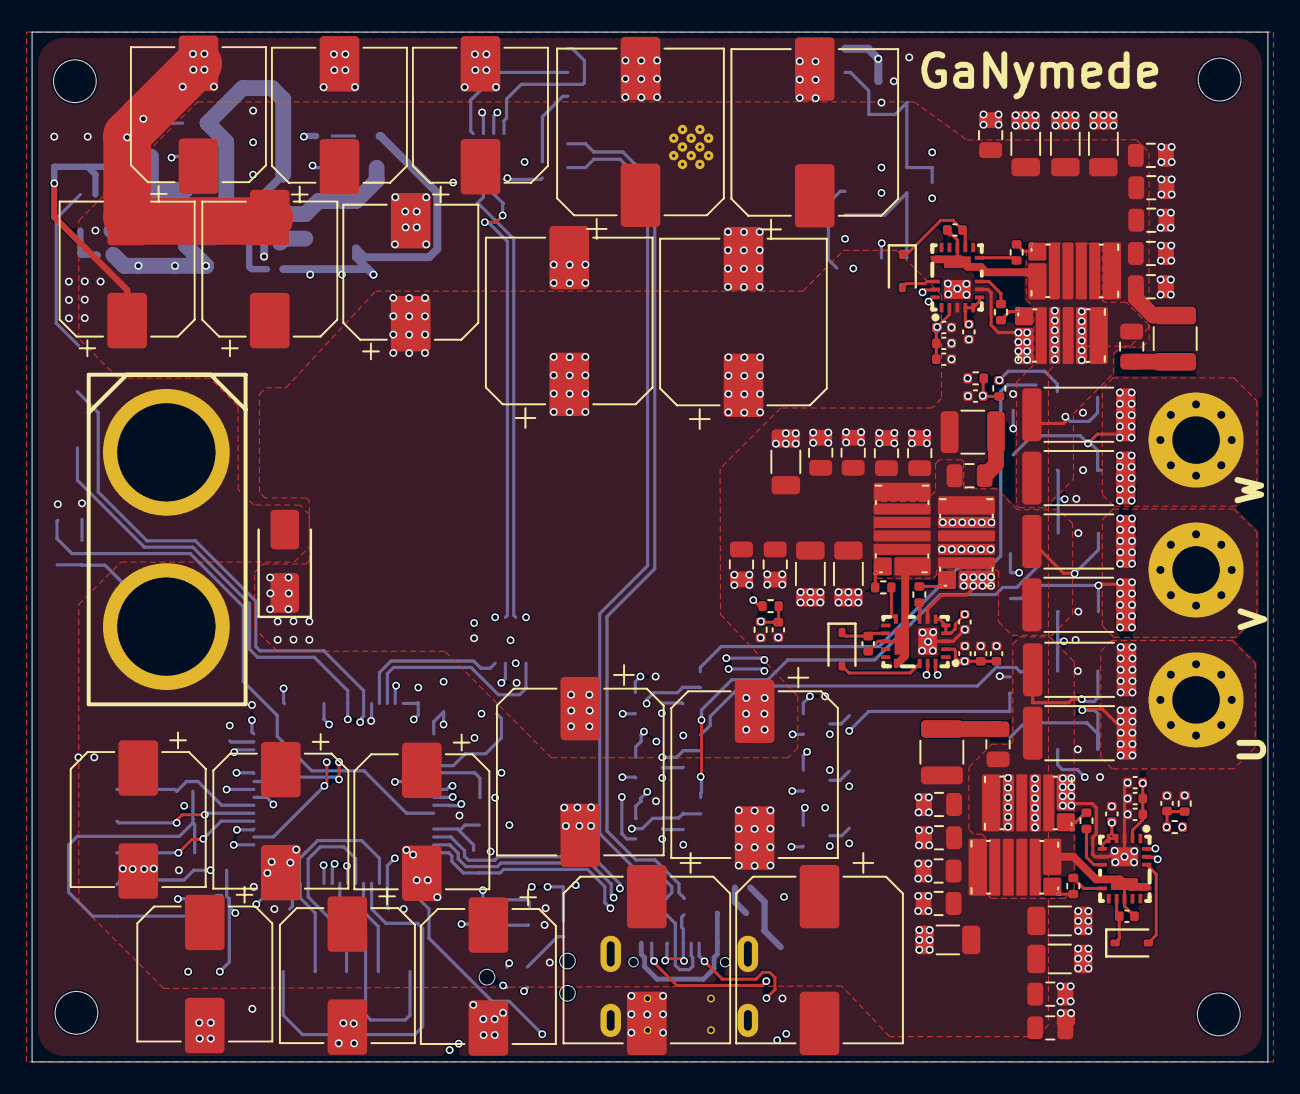
[picture p16: board GaNymede.kicad_pcb from above]

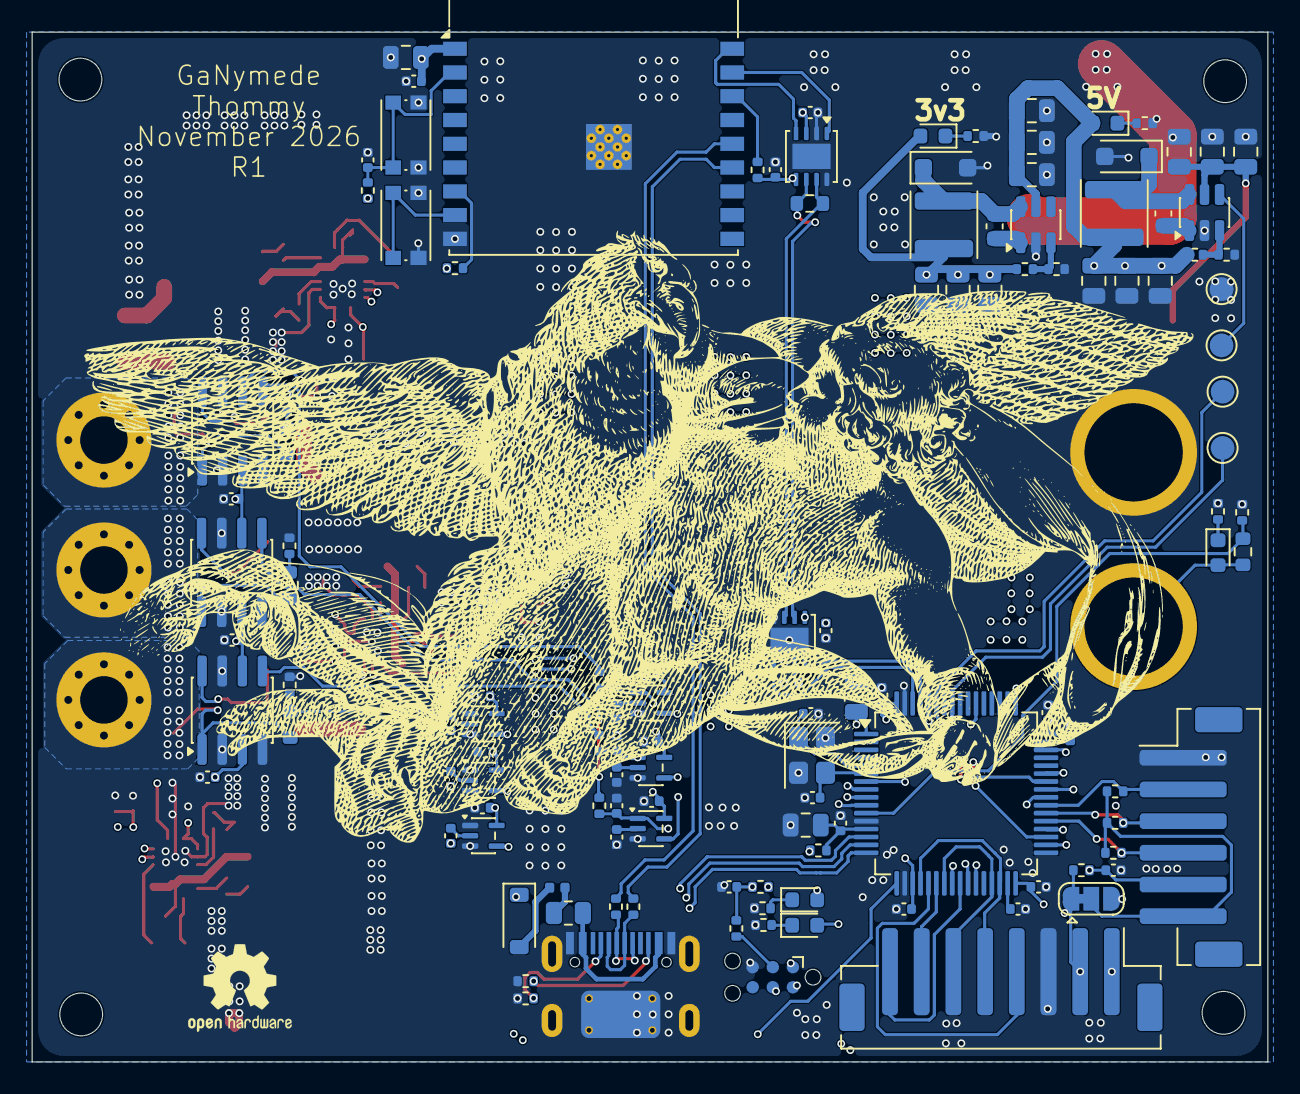
[picture p17: board GaNymede.kicad_pcb from below]

Board: 6 copper layers, 78.0 x 65.0 mm, 236 parts (126 on the bottom side), 110 nets.
