NovaPrime18/GaNymede/(commit log)

2026-11-08 Enhance README with compatibility and design details
    Updated the README to clarify the compatibility of the motor controller and added information about LLMs used in the design.
2026-11-08 Added housing
    [GaNymede-Housing-Housing-Bottom.step, GaNymede-Housing-Housing-Top.step, GaNymede-Housing.FCStd, GaNymede.kicad_pcb, GaNymede.step]
