NovaPrime18/GaNymede/(notices)

Notices in the files:
README.md:
License: CERN-OHL-S v2.0
